SanjayrajN-in/EVInverterPCB/Inverter.step

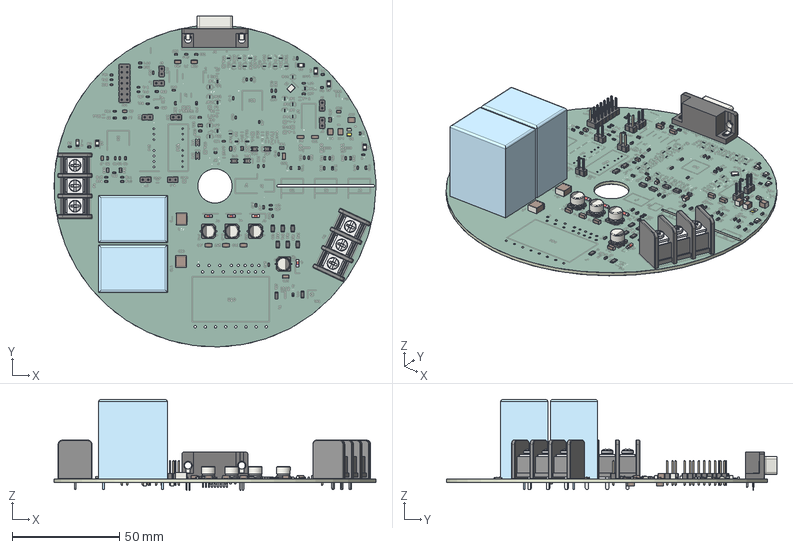
[picture p1: CAD file, 2026-11-03]
Inverter.step
150.0 x 154.1 x 42.4 mm
C_0603_1608Metric x 53
R_0603_1608Metric x 26
CP_Elec_63x59 x 4
LED_1206_3216Metric x 6
LED_1206_3216Metric_Castellated x 6
C_1210_3225Metric x 3
D_1206 x 12
R_1206_3216Metric x 8
C_1206_3216Metric x 13
C_0805_2012Metric x 7
C_2220_5750Metric x 2
PinHeader_1x02_P254mm_Vertical x 8
Crystal_SMD_EuroQuartz_MT-4Pin_3.2x2.5mm
L_0805_2012Metric x 3
D_MiniMELF_Standard x 4
DSUB-9_Pins_Horizontal_P2.77x2.84mm_EdgePinOffset4.94mm_Housed_ MountingHolesOffset4.94mm
PRT0001 x 2
PinHeader_2x07_P254mm_Vertical
Inverter-unsaved-export-OFHYW4_copper
Inverter-unsaved-export-OFHYW4_via
Inverter-unsaved-export-OFHYW4_silkscreen x 2
Inverter-unsaved-export-OFHYW4_soldermask x 2
Inverter-unsaved-export-OFHYW4_PCB
