SanjayrajN-in/EVInverterPCB/Inverter.kicad_pcb

## KiCad design Inverter.kicad_pcb (2026-11-03)

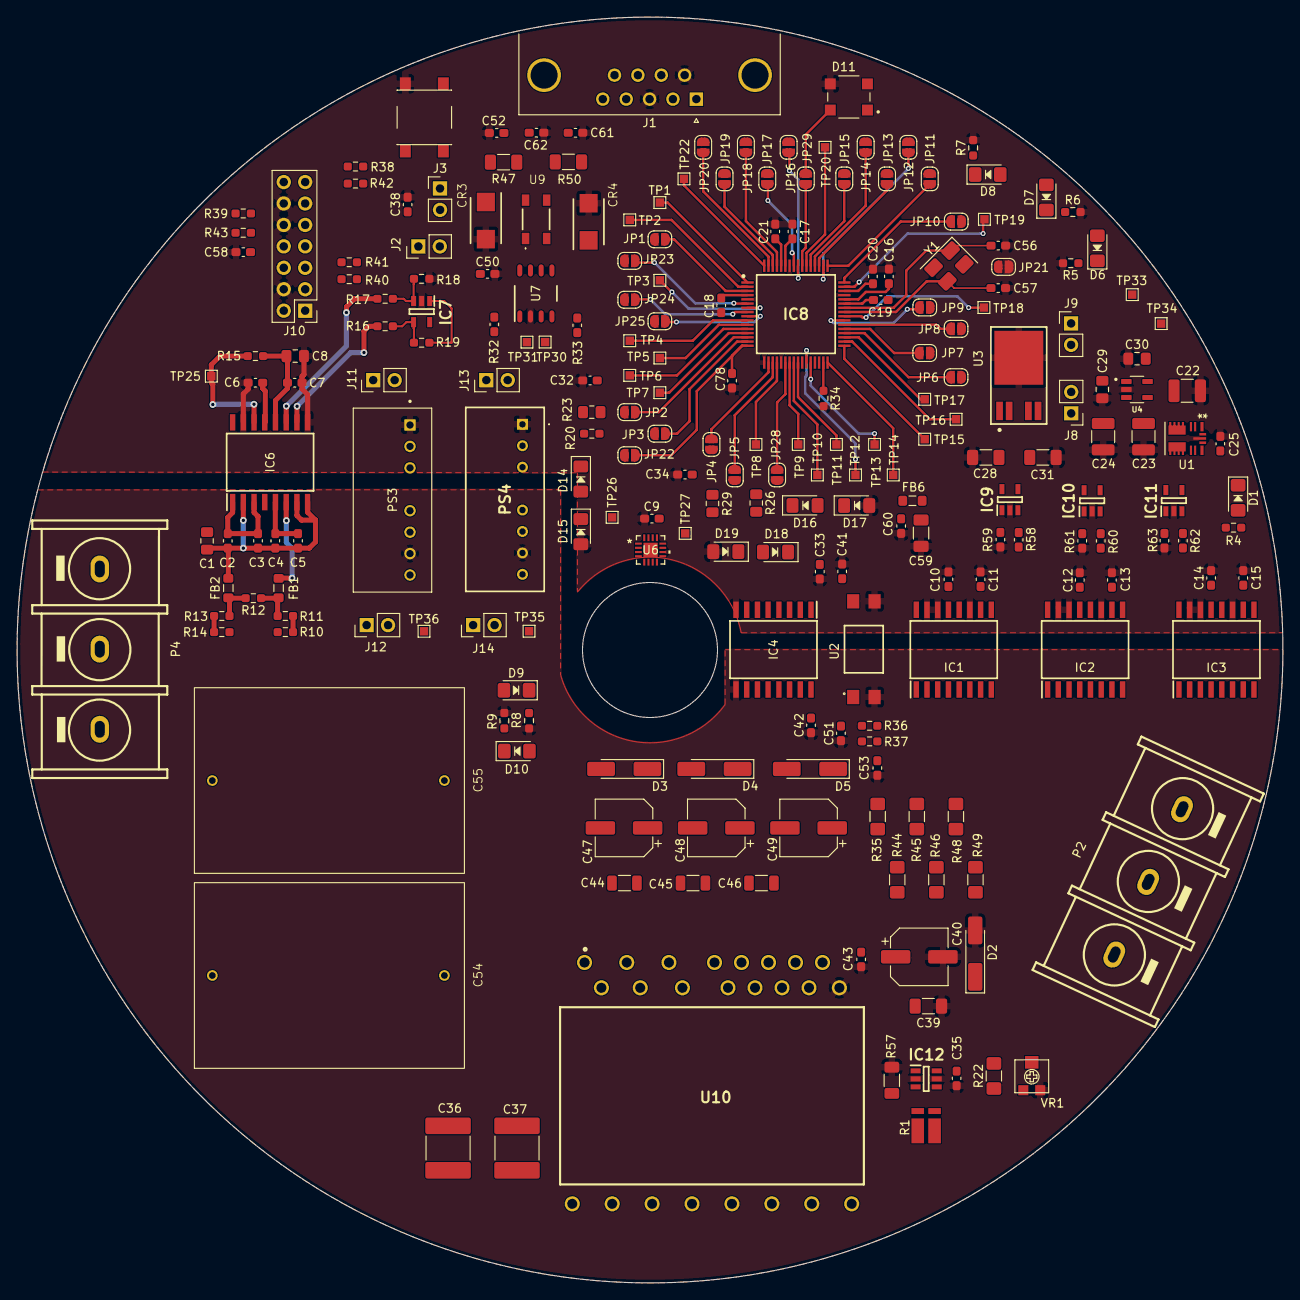
[picture p2: board Inverter.kicad_pcb from above]

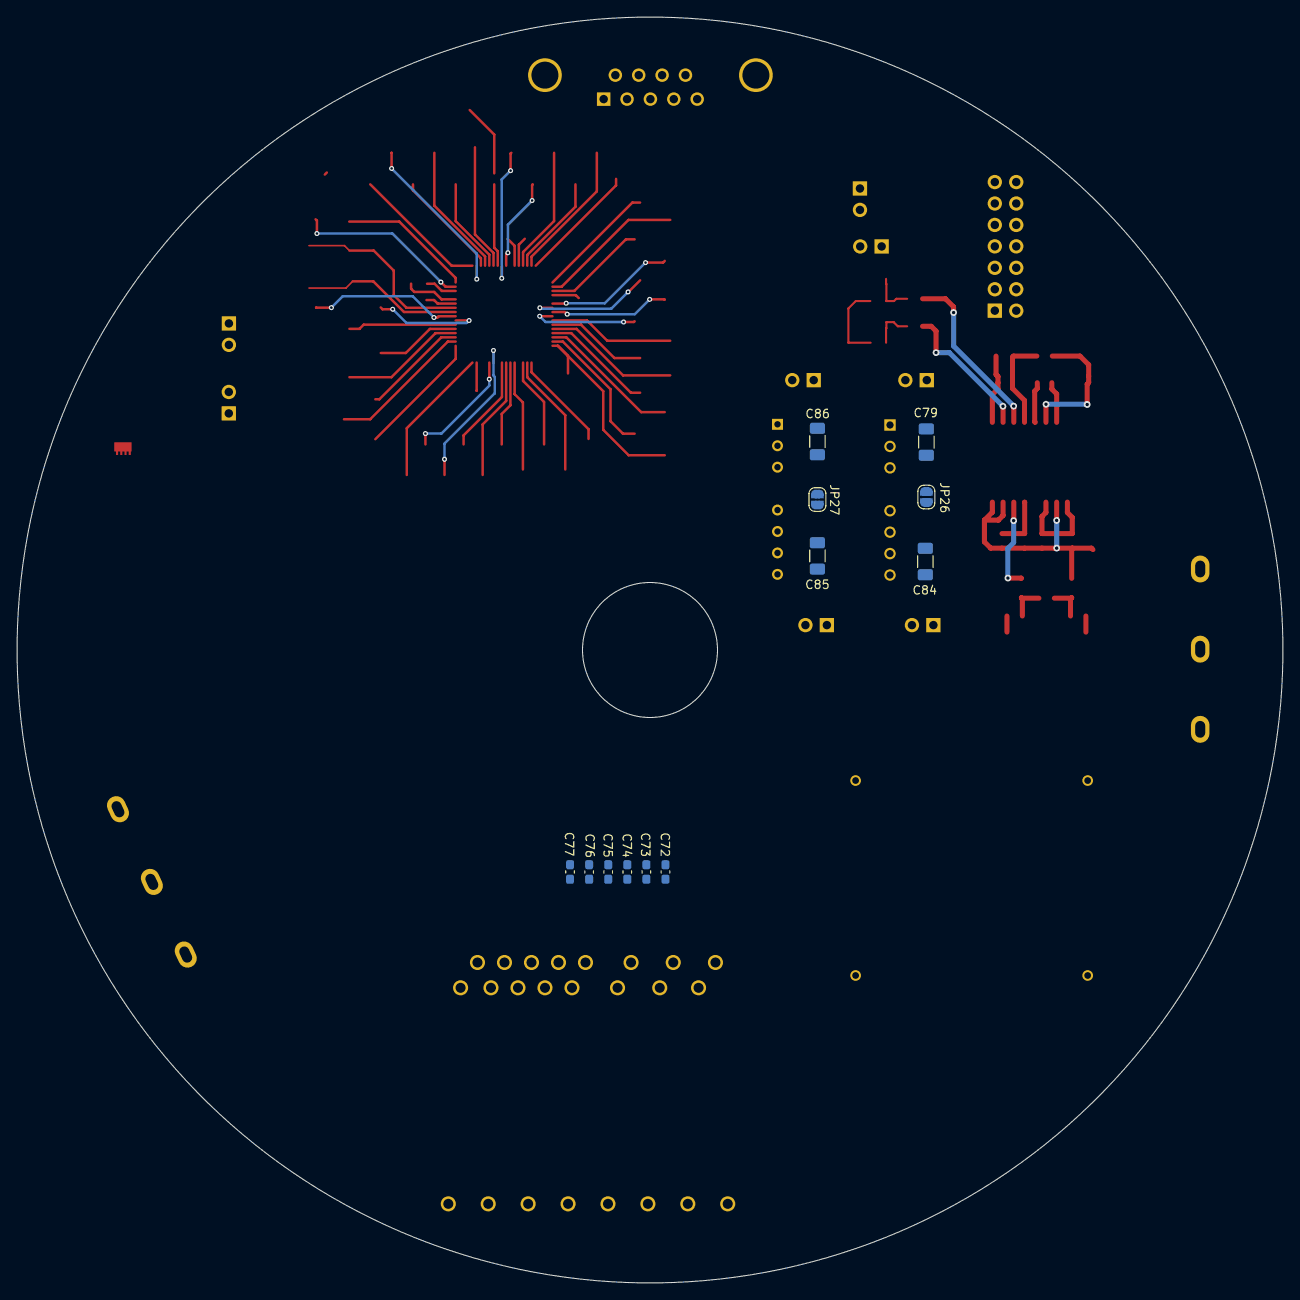
[picture p3: board Inverter.kicad_pcb from below]

Board: 2 copper layers, 150.0 x 150.0 mm, 236 parts (12 on the bottom side), 176 nets.

Parts:
C1, C8: 1u; C_0805_2012Metric_Pad1.18x1.45mm_HandSolder
C2, C5, C7: 1n; C_0603_1608Metric_Pad1.08x0.95mm_HandSolder
C3, C4, C6, C16, C17, C18, C19, C20, C21, C58, C60: 100n; C_0603_1608Metric_Pad1.08x0.95mm_HandSolder
C9, C25, C35: 1uF; C_0603_1608Metric_Pad1.08x0.95mm_HandSolder
C10, C12, C14, C43, C53: 1nF; C_0603_1608Metric_Pad1.08x0.95mm_HandSolder
C11, C41, C42, C51: 0.1uF; C_0603_1608Metric_Pad1.08x0.95mm_HandSolder
C13, C15, C38, C50, C52, C61, C62: 0.1u; C_0603_1608Metric_Pad1.08x0.95mm_HandSolder
C22: 4.7uF; C_1210_3225Metric_Pad1.33x2.70mm_HandSolder
C23, C24: 22uF; C_1210_3225Metric_Pad1.33x2.70mm_HandSolder
C28, C31, C84: 10uF; C_1206_3216Metric_Pad1.33x1.80mm_HandSolder
C29, C30: 10uF; C_0805_2012Metric_Pad1.18x1.45mm_HandSolder
C32, C33, C34, C72, C73, C74, C75, C76, C77: 100nF; C_0603_1608Metric_Pad1.08x0.95mm_HandSolder
C36, C37: 2.2u; C_2220_5750Metric_Pad1.97x5.40mm_HandSolder
C39: 1u; C_1206_3216Metric_Pad1.33x1.80mm_HandSolder
C40: 10u; CP_Elec_6.3x5.9
C44, C45, C46: 2.2uF; C_1206_3216Metric
C47, C48, C49: 100uF/25V; CP_Elec_6.3x5.9
C54, C55: 22u; FilmCap
C56, C57: 22pF; C_0603_1608Metric_Pad1.08x0.95mm_HandSolder
C59: 4.7u; C_1206_3216Metric_Pad1.33x1.80mm_HandSolder
C78: 2.2uF; C_0603_1608Metric_Pad1.08x0.95mm_HandSolder
C79, C85, C86: 47uF; C_1206_3216Metric_Pad1.33x1.80mm_HandSolder
CR3, CR4: SMBJ30CA; DIOM5436X244N
D1: RED_LED; LED_1206
D2, D3, D4, D5: 16V; D_MiniMELF_Handsoldering
D6, D7, D8, D9, D10: LED; LED_1206
D11: XL-5050RGBC-WS2812B; LED_XL-5050RGBC-WS2812B
D14, D15, D16, D17, D18, D19: D_Zener; D_1206
FB1, FB2, FB6: FerriteBead; L_0805_2012Metric_Pad1.05x1.20mm_HandSolder
IC1, IC2, IC3: ACS724LMATR-20AB-T; SOIC127P1030X265-16N
IC4: ISO7760FQDWQ1; SOIC127P1030X265-16N
IC6: AMC3311QDWERQ1; SOIC127P1030X265-16N
IC7, IC9, IC10, IC11: OPA388QDBVRQ1; SOT95P280X145-5N
IC8: F2800157QPMQ1; QFP50P1200X1200X160-64N
IC12: INA181A2QDBVRQ1; SOT95P280X145-6N
J1: Conn_01x09_Pin; DSUB-9_Pins_Horizontal_P2.77x2.84mm_EdgePinOffset4.94mm_Hou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
J2, J3, J8, J9, J11, J12, J13, J14: Conn_01x02_Pin; PinHeader_1x02_P2.54mm_Vertical
J10: Conn_02x07_Odd_Even; PinHeader_2x07_P2.54mm_Vertical
JP1, JP2, JP3, JP4, JP5, JP6, JP7, JP8, JP9, JP10, JP11, JP12, JP13, JP14, JP15, JP16, JP17, JP18, JP19, JP20, JP21, JP22, JP23, JP24, JP25, JP26, JP27, JP28, JP29: SolderJumper_2_Open; SolderJumper-2_P1.3mm_Open_RoundedPad1.0x1.5mm
P2, P4: WJ45C-B-3P
PS3: MCWI05-12S05; CONV_MCWI05-12S05
PS4: MCWI05-12S15; MCWI0512S15
R1: 0.0007; WSK1216
R4, R12, R34, R37, R38, R39, R40, R41, R42, R43: 10k; R_0603_1608Metric_Pad0.98x0.95mm_HandSolder
R5, R6, R7, R8, R9: 2.2k; R_0603_1608Metric_Pad0.98x0.95mm_HandSolder
R10, R14, R16, R17, R18, R19: 100k; R_0603_1608Metric_Pad0.98x0.95mm_HandSolder
R11, R13: 150k; R_0603_1608Metric_Pad0.98x0.95mm_HandSolder
R15: 47k; R_0603_1608Metric_Pad0.98x0.95mm_HandSolder
R20: 100; R_0603_1608Metric_Pad0.98x0.95mm_HandSolder
R22, R35, R44, R45, R46, R48, R49: R; R_1206
R23, R26, R29: 100; C_0805_2012Metric_Pad1.18x1.45mm_HandSolder
R32, R33: 50; C_0603_1608Metric_Pad1.08x0.95mm_HandSolder
R36: 220; R_0603_1608Metric_Pad0.98x0.95mm_HandSolder
R47, R50: 60; C_1206_3216Metric_Pad1.33x1.80mm_HandSolder
R57: 0R; R_1206_3216Metric_Pad1.30x1.75mm_HandSolder
R58, R60, R62: 10k; C_0603_1608Metric_Pad1.08x0.95mm_HandSolder
R59, R61, R63: 19.6k; C_0603_1608Metric_Pad1.08x0.95mm_HandSolder
SW1: SW_MEC_5E; PushButton
TP1, TP2, TP3, TP4, TP5, TP6, TP7, TP8, TP9, TP10, TP11, TP12, TP13, TP14, TP15, TP16, TP17, TP18, TP19, TP20, TP22, TP25, TP26, TP27, TP30, TP31, TP33, TP34, TP35, TP36: TestPoint; TestPoint_Pad_1.0x1.0mm
U1: TPSM33610S5QRDNRQ1
U2: VO617A-3X018T; SOIC254P1210X390-4N
U3: TPS78533QKVURQ1; TO114P998X235-6_5N-V
U4: TLV70012QDDCRQ1; SOT95P280X110-5N
U6: MA732GQ-P; QFN-16_MA732
U7: TCAN1042HGVDRQ1; D0008A_N
U9: ACT45C-110-2P-TL000
U10: IGCM15F60GA
VR1: EVM-3YSX50B53
Y1: Crystal_GND24; Crystal_SMD_EuroQuartz_MT-4Pin_3.2x2.5mm_HandSoldering

Connections:
+1V2: C16.1, C17.1, C18.1, D8.2 (A), IC8.4 (VDD_1), IC8.44 (VDD_2), IC8.59 (VDD_3), J9.1, TP33.1 (1_1)
+3.3V: C9.1, C19.1, C20.1, C21.1, C41.2, D7.2 (A), FB6.1, IC4.1 (VCC1), IC7.5 (V+), IC8.43 (VDDIO_1), IC8.46 (VREGENZ), IC8.60 (VDDIO_2), J3.1, J8.2, J10.5, R38.1, R39.1, R40.1, R41.1, R42.1, R43.2, TP34.1 (1_1), U6.13 (VDD)
+5V: C7.2, C8.2, C11.1, C13.1, C15.1, C23.1, C24.1, C28.2, D6.2 (A), D11.1 (VDD), IC1.10 (VCC), IC2.10 (VCC), IC3.10 (VCC), IC6.12 (VDD), J2.1, R15.1, U1.4 (VOUT), U1.9 (FB), U3.1 (EN), U3.2 (IN)
+5VA: C35.1, C42.2, D10.2 (A), IC4.16 (VCC2), IC12.6 (VS), J12.2, R37.1, TP36.1 (1_1)
+12V: C22.1, J1.9, J11.1, J13.1, R4.1, U1.2 (EN), U1.3 (VIN)
+15V: C39.1, C40.1, D2.1 (K), D9.2 (A), J14.2, TP35.1 (1_1), U10.13 (VDD)
+DCLink: C36.2, C37.1, C54.2, C55.1, P4.1, R10.1, U10.23
+INSense: IC12.3 (IN+), R1.3
-DCLink: C36.1, C37.2, C54.1, C55.2, P4.3, R1.1, R14.2, R57.1
-INSense: IC12.4 (IN-), R1.2
/Interface/VCC: C50.1, J2.2, U7.3 (VCC)
/Interface/VIO: C38.1, J3.2, U7.5 (VIO)
/Inverter_PowerStage/A: C72.1, R35.2, U10.7 (HIN(U))
/Inverter_PowerStage/B: C73.1, R44.2, U10.8 (HIN(V))
/Inverter_PowerStage/C: C74.1, R45.2, U10.9 (HIN(W))
/Inverter_PowerStage/D: C75.1, R46.2, U10.10 (LIN(U))
/Inverter_PowerStage/E: C76.1, R48.2, U10.11 (LIN(V))
/Inverter_PowerStage/F: C77.1, R49.2, U10.12 (LIN(W))
/Power_SM/PGOOD: D1.1 (K), U1.1 (PGOOD)
ADC_IU: C32.1, D14.2 (A), D15.1 (K), JP2.2 (B), R23.1
ADC_IV: C33.1, D16.2 (A), D17.1 (K), JP5.2 (B), R26.1
ADC_IW: C34.1, D18.2 (A), D19.1 (K), JP4.2 (B), R29.1
AD_REF: C59.1, C60.1, D14.1 (K), D16.1 (K), D18.1 (K), FB6.2, IC9.5 (V+), IC10.5 (V+), IC11.5 (V+), JP22.2 (B), JP28.2 (B)
CAN1RX: R33.2, TP30.1 (1_1), U7.4 (RXD)
CAN1TX: R32.2, TP31.1 (1_1), U7.1 (TXD)
CANH: C52.1, J1.7, R47.1, U9.4
CANL: C61.2, J1.2, R50.2, U9.3
CANSTB: IC8.31 (GPIO11), R34.1, U7.8 (STB)
DC_OUTN: IC6.10 (OUTN), R16.2
DC_OUTP: IC6.11 (OUTP), R17.2
DC_Sense: JP3.2 (B), R20.2
DIN_LED: D11.4 (DIN), JP29.1 (A)
EMU0: J10.13, R38.2
EMU1: J10.14, R39.2
GND: C6.2, C7.1, C8.1, C9.2, C10.2, C11.2, C12.2, C13.2, C14.2, C15.2, C16.2, C17.2, C18.2, C19.2, C20.2, C21.2, C22.2, C23.2, C24.2, C25.2, C28.1, C29.1, C30.1, C31.2, C32.2, C33.2, C34.2, C38.2, C41.1, C50.2, C52.2, C56.2, C57.1, C58.2, C59.2, C60.2, C61.1, C62.2, C78.2, C79.2, C86.1, CR3.2, CR4.2, D11.3 (GND), D15.2 (A), D17.2 (A), D19.2 (A), IC1.11 (NC_2), IC1.14 (NC_3), IC1.15 (GND), IC2.11 (NC_2), IC2.14 (NC_3), IC2.15 (GND), IC3.11 (NC_2), IC3.14 (NC_3), IC3.15 (GND), IC4.8 (GND1), IC6.9 (GND), IC6.15 (DCDC_GND), IC7.2 (V-), IC8.5 (VSS_1), IC8.17 (VREFLO), IC8.21 (VSSA), IC8.26 (VSS_2), IC8.45 (VSS_3), IC8.58 (VSS_4), IC9.2 (V-), IC10.2 (V-), IC11.2 (V-), J1.3, J1.6, J10.4, J10.10, J10.12, JP21.1 (A), JP26.2 (B), JP27.2 (B), PS3.1 (-VIN), PS4.1 (-VIN), R5.2, R6.2, R7.2, R18.2, R34.2, R59.2, R61.2, R63.2, SW1.2, U1.10 (GND), U1.11 (MODE/SYNC), U2.3, U3.3 (GND), U4.2 (GND), U6.8 (GND), U6.10 (TEST), U6.17 (PAD), U7.2 (GND)
GND1: C35.2, C39.2, C40.2, C42.1, C43.2, C51.2, C53.2, C72.2, C73.2, C74.2, C75.2, C76.2, C77.2, C84.2, C85.2, D2.2 (A), IC4.9 (GND2), IC12.2 (GND), IC12.5 (REF), PS3.7 (-VOUT), PS4.7 (-VOUT), R8.2, R9.2, R57.2, U2.2, U10.16 (VSS), VR1.P$3
ITRIP: C43.1, R22.2, U10.15 (ITRIP), VR1.P$1, VR1.P$2
ITRIPOUT: IC12.1 (OUT), R22.1
Iu_In: IC1.1 (IP+_1), IC1.2 (IP+_2), IC1.3 (IP+_3), IC1.4 (IP+_4), U10.22 (U)
Iu_Out: IC1.5 (IP-_1), IC1.6 (IP-_2), IC1.7 (IP-_3), IC1.8 (IP-_4), P2.1
Iu_div: IC9.3 (+IN), R58.2, R59.1
Iu_sense: IC1.12 (VIOUT), R58.1
Iv_In: IC2.1 (IP+_1), IC2.2 (IP+_2), IC2.3 (IP+_3), IC2.4 (IP+_4), U10.21 (V)
Iv_Out: IC2.5 (IP-_1), IC2.6 (IP-_2), IC2.7 (IP-_3), IC2.8 (IP-_4), P2.2
Iv_div: IC10.3 (+IN), R60.2, R61.1
Iv_sense: IC2.12 (VIOUT), R60.1
Iw_In: IC3.1 (IP+_1), IC3.2 (IP+_2), IC3.3 (IP+_3), IC3.4 (IP+_4), U10.20 (W)
Iw_Out: IC3.5 (IP-_1), IC3.6 (IP-_2), IC3.7 (IP-_3), IC3.8 (IP-_4), P2.3
Iw_div: IC11.3 (+IN), R62.2, R63.1
Iw_sense: IC3.12 (VIOUT), R62.1
JTAG_SEL: C58.1, J10.8, R43.1
unnamed: C62.1, R47.2, R50.1
unnamed: D1.2 (A), R4.2
unnamed: D6.1 (K), R5.1
unnamed: D7.1 (K), R6.1
unnamed: D8.1 (K), R7.1
unnamed: D9.1 (K), R8.1
unnamed: D10.1 (K), R9.1
unnamed: FB1.1, R11.2, R12.1
unnamed: FB2.1, R12.2, R13.1
unnamed: C10.1, IC1.13 (FILTER)
unnamed: C12.1, IC2.13 (FILTER)
unnamed: C14.1, IC3.13 (FILTER)
unnamed: IC4.15 (OUTA), R49.1
unnamed: IC4.14 (OUTB), R48.1
unnamed: IC4.13 (OUTC), R46.1
unnamed: IC4.12 (OUTD), R45.1
unnamed: IC4.11 (OUTE), R44.1
unnamed: IC4.10 (OUTF), R35.1
unnamed: C1.1, C2.1, C3.1, C4.1, C5.2, FB2.2, IC6.2 (DCDC_HGND), IC6.7 (HGND_1), IC6.8 (HGND_2)
unnamed: C6.1, IC6.13 (LDO_OUT), IC6.16 (DCDC_IN)
unnamed: C1.2, C2.2, C3.2, IC6.1 (DCDC_OUT), IC6.3 (HLDO_IN)
unnamed: IC6.14 (DIAG), R15.2, TP25.1 (1_1)
unnamed: C4.2, C5.1, IC6.5 (HLDO_OUT)
unnamed: FB1.2, IC6.6 (IN)
unnamed: IC7.3 (+IN), R17.1, R18.1
unnamed: IC7.4 (-IN), R16.1, R19.1
unnamed: IC7.1 (OUT), R19.2, R20.1
unnamed: IC8.15 (A0/C15/CMP1_DACL), JP3.1 (A)
unnamed: IC8.14 (A1), JP2.1 (A)
unnamed: IC8.9 (A2/C9GPIO224), JP25.2 (B)
unnamed: IC8.8 (A3/C5GPIO242), JP24.2 (B)
unnamed: IC8.23 (A4/C14), TP9.1 (1_1)
unnamed: IC8.13 (A5/C2), TP7.1 (1_1)
unnamed: IC8.6 (A6GPIO228), JP23.2 (B)
unnamed: IC8.19 (A7/C3), JP5.1 (A)
unnamed: IC8.20 (A8/C11), TP8.1 (1_1)
unnamed: IC8.25 (A10/C10GPIO230), TP11.1 (1_1)
unnamed: IC8.12 (A11/C0), TP6.1 (1_1)
unnamed: IC8.18 (A12/C1), JP4.1 (A)
unnamed: IC8.10 (A15/C7), TP4.1 (1_1)
unnamed: IC8.2 (A16/C16GPIO28), TP2.1 (1_1)
unnamed: IC8.27 (A17/C17GPIO20), TP12.1 (1_1)
unnamed: IC8.28 (A18/C18GPIO21), TP13.1 (1_1)
unnamed: IC8.29 (A19/C19GPIO13), R32.1
unnamed: IC8.30 (A20/C20GPIO12), R33.1
unnamed: IC8.11 (C4/A14), TP5.1 (1_1)
unnamed: IC8.7 (C6GPIO226), TP3.1 (1_1)
unnamed: IC8.24 (C8/A9GPIO227), TP10.1 (1_1)
unnamed: IC8.52 (GPIO0), JP14.2 (B)
unnamed: IC8.51 (GPIO1), JP13.2 (B)
unnamed: IC8.50 (GPIO2), JP12.2 (B)
unnamed: IC8.49 (GPIO3), JP11.2 (B)
unnamed: IC8.48 (GPIO4), JP10.1 (A)
unnamed: IC8.61 (GPIO5), JP18.2 (B)
unnamed: IC8.64 (GPIO6), TP22.1 (1_1)
unnamed: IC8.57 (GPIO7), JP17.2 (B)
unnamed: IC8.47 (GPIO8), TP19.1 (1_1)
unnamed: IC8.62 (GPIO9), JP19.2 (B)
unnamed: IC8.63 (GPIO10), JP20.2 (B)
unnamed: IC8.33 (GPIO16), TP15.1 (1_1)
unnamed: IC8.34 (GPIO17), TP16.1 (1_1)
unnamed: IC8.56 (GPIO22), JP16.2 (B)
unnamed: IC8.54 (GPIO23), TP20.1 (1_1)
unnamed: IC8.35 (GPIO24), TP17.1 (1_1)
unnamed: IC8.1 (GPIO29), TP1.1 (1_1)
unnamed: IC8.40 (GPIO32), TP18.1 (1_1)
unnamed: IC8.32 (GPIO33), TP14.1 (1_1)
unnamed: IC8.39 (GPIO35/TDI), JP9.2 (B)
unnamed: IC8.37 (GPIO37/TDO), JP7.2 (B)
unnamed: IC8.53 (GPIO40), JP15.2 (B)
unnamed: IC8.55 (GPIO41), JP29.2 (B)
unnamed: IC8.36 (TCK), JP6.2 (B)
unnamed: IC8.38 (TMS), JP8.1 (A)
unnamed: IC8.22 (VDDA), JP28.1 (A)
unnamed: IC8.3 (XRSN), JP1.2 (B)
unnamed: IC9.1 (OUT), IC9.4 (-IN), R23.2
unnamed: IC10.1 (OUT), IC10.4 (-IN), R26.2
unnamed: IC11.1 (OUT), IC11.4 (-IN), R29.2
unnamed: C29.2, C31.1, J8.1, U3.4 (OUT), U4.1 (IN), U4.3 (EN)
unnamed: C30.2, J9.2, U4.5 (OUT)
unnamed: C79.1, J11.2, PS3.2 (+VIN)
unnamed: C84.1, J12.1, PS3.6 (+VOUT)
unnamed: C86.2, J13.2, PS4.2 (+VIN)
unnamed: C85.1, J14.1, PS4.6 (+VOUT)
unnamed: JP21.2 (B), Y1.2 (G), Y1.4 (G)
unnamed: JP26.1 (A), PS3.3 (REMOTE_ON/OFF)
unnamed: JP27.1 (A), PS4.3 (REMOTE_ON/OFF)
unnamed: R10.2, R11.1
unnamed: R13.2, R14.1
unnamed: C25.1, U1.8 (VCC)
unnamed: TP26.1 (1_1), U6.16 (MGH)
unnamed: TP27.1 (1_1), U6.11 (MGL)
unnamed: CR3.1, U7.7 (CANH), U9.1
unnamed: CR4.1, U7.6 (CANL), U9.2
unnamed: R1.4, U10.17 (NW), U10.18 (NV), U10.19 (NU)
PWMA1: IC4.7 (INF), JP14.1 (A)
PWMA2: IC4.4 (INC), JP13.1 (A)
PWMB1: IC4.6 (INE), JP12.1 (A)
PWMB2: IC4.3 (INB), JP11.1 (A)
PWMC1: IC4.5 (IND), JP10.2 (B)
PWMC2: IC4.2 (INA), JP18.1 (A)
SPIACLK: JP19.1 (A), U6.12 (SCLK)
SPIACS: JP16.1 (A), U6.5 (CS)
SPIAMISO: JP20.1 (A), U6.7 (MISO)
SPIAMOSI: JP17.1 (A), U6.4 (MOSI)
TCK: J10.11, JP6.1 (A), R42.2
TDI: J10.3, JP9.1 (A), R41.2
TDO: J10.7, JP7.1 (A)
TMS: J10.1, JP8.2 (B), R40.2
VB(U): C44.2, C47.1, D3.1 (K), U10.2 (VB(U))
VB(V): C45.2, C48.1, D4.1 (K), U10.4 (VB(V))
VB(W): C46.1, C49.1, D5.1 (K), U10.6 (VB(W))
VFO: C53.1, R36.1, R37.2, U10.14 (VFO)
VFO(I): C51.1, R36.2, U2.1
VFO(O): JP15.1 (A), U2.4
VREFHI: C78.1, IC8.16 (VREFHI), JP22.1 (A)
VS(U): C44.1, C47.2, D3.2 (A), U10.1 (VS(U))
VS(V): C45.1, C48.2, D4.2 (A), U10.3 (VS(V))
VS(W): C46.2, C49.2, D5.2 (A), U10.5 (VS(W))
X1: C56.1, IC8.42 (GPIO19X1), Y1.1
X2: C57.2, IC8.41 (GPIO18X2), Y1.3
XRSn: J10.2, JP1.1 (A), SW1.3 (K)
eQEPA: JP25.1 (A), U6.2 (A)
eQEPB: JP23.1 (A), U6.6 (B)
eQEPZ: JP24.1 (A), U6.3 (Z)
