SanjayrajN-in/EVInverterPCB/(commit log)

2026-08-24 Power Supply Section is Complete
    [Interface.kicad_sch, Inverter.kicad_pcb, Inverter.kicad_sch, mcu_core.kicad_sch, power_sm.kicad_sch, sensors.kicad_sch]
2026-08-24 Added Pin configuration
2026-09-03 CIPOS circuit
    [Interface.kicad_sch, Inverter.kicad_sch, Inverter_PowerStage.kicad_sch, power_sm.kicad_sch, sensors.kicad_sch]
2026-10-30 Sync repository with current local project state
    Update schematics, PCB, and project files, replace outdated component
    libraries, and refresh KiCad backups.
2026-11-03 Update schematics, PCB, and libraries (add TCAN1042, SMBJ30CA, DSUB-9 parts)
2026-11-03 Update PCB layout
2026-11-03 Update PCB layout and MCU schematic
2026-11-03 Update inverter PCB design and component libraries
